eSpark-Backup/alexy-ouden-industrial-iot-board/Design Files/Industrial IOT development board-v2.0/Deliverables/Renderings/3D-ISOMETRIC-view.png

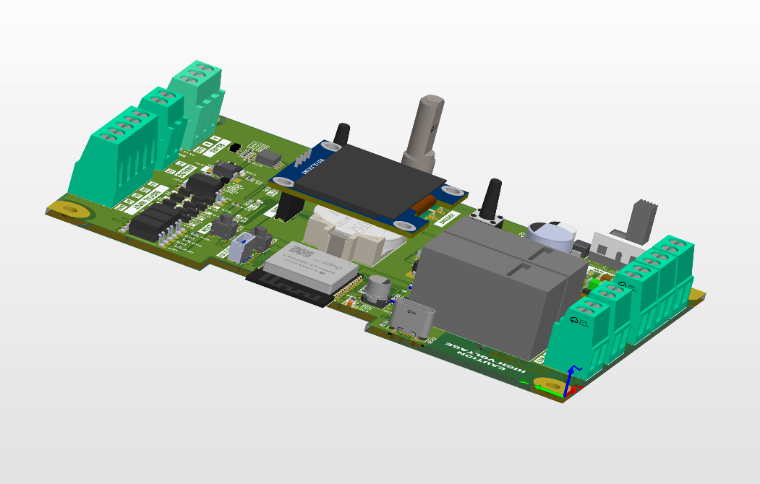
Design Files/Industrial IOT development board-v2.0/Deliverables/Renderings/3D-ISOMETRIC-view.png
