eSpark-Backup/alexy-ouden-industrial-iot-board/Design Files/Industrial IOT development board-v2.0/BOM/Industrial_IOT_Dev_Brd-v2.0.xlsx

# | Item Type | Designator | Description | Footprint | Manufacturer Part Number | Manufacturer | Value | Quantity | Remarks
1 | Capacitor | C1, C7 | CAP CER 0.1UF 50V X7R 0603 | Cap-0603 | CL10B104KB8WPNC | Samsung | 0.1uF | 2
2 | Capacitor | C2 | CAP ALUM 220UF 20% 50V SMD | UCD-220uF-10mmDia | UCD1H221MNL1GS | Nichicon | 220uF | 1
3 | Capacitor | C3 | 47uF 50V 66mA@120Hz ±20% SMD,D6.3xL7.7mm Aluminum Electrolytic Capacitors - SMD ROHS | RVT1H470M0607 | RVT1H470M0607 | ROQANG | 47uF | 1
4 | Capacitor | C4 | CAP CER 0.022UF 100V X7R 0805 | Cap-0805 | CC0805JRX7R0BB223 | Yageo | 22nF | 1
5 | Capacitor | C5, C18, C19 | CAP CER 10UF 50V X7R 1210 | Cap-1210 | GRM32ER71H106KA12L | Murata | 10uF | 3
6 | Capacitor | C6, C17 | CAP CER 1UF 50V X5R 0603 | Cap-0603 | CL10A105KB8NNNC | Samsung | 1uF | 2
7 | Capacitor | C8 | CAP CER 10UF 50V X7R 1210 | Cap-1210 | CC1210KKX7R9BB106 | Yageo | 10uF | 1
8 | Capacitor | C9, C10, C32 | CAP CER 22UF 10V X7R 0805 | Cap-0805 | GRM21BZ71A226ME15L | Murata | 22uF | 3
9 | Capacitor | C22, C30, C33, C34, C35, C37, C38, C39, C45, C78 | CAP CER 0.1UF 16V X7R 0402 | Cap-0402 | CC0402JRX7R7BB104 | Yageo | 0.1uF | 10
10 | Capacitor | C27 | CAP ALUM POLY 120UF 20% 20V SMD | 20SVPF120M | 20SVPF120M | Panasonic | 120uF | 1
11 | Capacitor | C29 | CAP CER 1UF 6.3V X7R 0402 | Cap-0402 | GRM155R70J105KA12J | Murata | 1uF | 1
12 | Capacitor | C31 | 47uF 25V 49mA@120Hz ±20% SMD,D5xL5.4mm Aluminum Electrolytic Capacitors - SMD ROHS | RVT1E470M0505 | RVT1E470M0505 | ROQANG | 47uF | 1
13 | Capacitor | C40 | CAP CER 10PF 50V C0G/NP0 0402 | Cap-0402 | GRM1555C1H100JA01D | Murata | 10pF | 1
14 | Capacitor | ~~C41~~ | ~~CAP CER 10PF 50V C0G/NP0 0402~~ | ~~Cap-0402~~ | ~~GRM1555C1H100JA01D~~ | ~~Murata~~ | ~~DNP~~ | ~~1~~ | ~~DO NOT PLACE~~
15 | Diode | D1 | TVS DIODE 58VWM 93.6VC SMB | SMB_ | SMBJ58A-13-F | Diodes | SMBJ58A-13-F | 1
16 | Diode | D2, D15, D21, D27, D33 | 26.7V 24V SOD-123 ESD and Surge Protection (TVS/ESD) ROHS | SOD-123 | AZ4024-01G | AMAZING | AZ4024-01G | 5
17 | Diode | D3 | 18A 250W 8V 5.5V Bidirectional 5V SOD-323 ESD and Surge Protection (TVS/ESD) ROHS | SOD-323 (Bi-directional) | PESD5V0S1BA,115-ES | ElecSuper | PESD5V0S1BA,115-ES | 1
18 | Diode | D4 | TVS DIODE 26VWM 42.1VC SMB | SMB_ | SMBJ26A-13-F | Diodes | SMBJ26A-13-F | 1
19 | Diode | D5 | 30A 360W 7V 3.5V Bidirectional 3.3V SOD-323 ESD and Surge Protection (TVS/ESD) ROHS | SOD-323 (Bi-directional) | PESD3V3L1BA-N-ES | ElecSuper | PESD3V3L1BA-N-ES | 1
20 | Diode | D8 | 30V Dual Common Cathode 1V@100mA 200mA SOT-23(TO-236) Schottky Barrier Diodes (SBD) ROHS | SOT-23 | BAT54C | Shandong Jingdao Microelectronics | BAT54C | 1
21 | Diode | D9, D10, D13, D19, D25, D31 | DIODE GEN PURP 100V 300MA SOD123 | SOD-123 | 1N4148W-7-F | Diodes | 1N4148W-7-F | 6
22 | Diode | D16, D22, D28, D34 | Independent Type 22.8V~25.6V 500mW 24V SOD-123 Zener Diodes ROHS | SOD-123 | BZT52C24 | BORN | BZT52C24 | 4
23 | Diode | D37, D41 | TVS DIODE 12VWM 19.9VC DO214AA | SMB_ | SMBJ12A | Littelfuse | SMBJ12A | 2
24 | Diode | D39, D43 | DIODE ZENER 3.3V 200MW SOD323F | SOD323F | MM3Z3V3B | ON Semiconductor / Fairchild | MM3Z3V3B | 2
25 | Diode | D50 | SOT-23 TVS ROHS | SOT-23 | SM712 | TECH PUBLIC | SM712 | 1
26 | Fuse | F1 | 24V 750mA 100A 1.5A 1210 Resettable Fuses ROHS | FUSE-1210 | 1210L075/24PR | Littlefuse | 1210L075/24PR | 1
27 | Fuse | F2 | 6V 1.5A 50A 3A 0805 Resettable Fuses ROHS | Fuse-0805 | 0805L150SLYR | Littelfuse | 0805L150SLYR | 1
28 | Fuse | F3 | PTC Resettable Fuse 6V 100A 2-Pin 0805 T/R | Fuse-0805 | SMD0805B110TF | Yageo | SMD0805B110TF | 1
29 | Ferrite Bead | FB1 | Ferrite Beads Multi-Layer 120Ohm 25% 100MHz 2A 50mOhm DCR 0603 Paper T/R | IND-0603 (1608 Metric) | BLM18PG121SN1D | Murata Electronics | 120R | 1
30 | Terminal Block | J1, J9, J10, J13, J14, J20 | 1x2P 18A -40℃~+105℃ 250V Green 12~30 Straight 5.08mm 2.5 1 2 Plugin,P=5.08mm Screw terminal ROHS | DB128L-5.08-2P-GN-S | DB128L-5.08-2P-GN-S | DORABO | DB128L-5.08-2P-GN-S | 6
31 | USB Connector | J2 | 5A 1 16P Mother -25℃~+85℃ Type-C SMD USB Connectors ROHS | U263-163N-4BQC65 | U263-163N-4BQC65 | XKB Connection | U263-163N-4BQC65 | 1
32 | Header | J3 | 1x6P SH 1 1mm 6 SMD,P=1mm Wire To Board / Wire To Wire Connector ROHS | Voltlink Target | C145963 | BOOMELE | Voltlink Target | 1
33 | Header | J4 | 2mm 2.54mm Plugin 2.5A -40℃~+105℃ Straight 1x4P Top 8.5mm 4 Square Hole Plugin,P=2.54mm Female Headers ROHS | HDR1X4 Female | PM2.54-1*4 | ZHOURI | PM2.54-1*4 | 1
34 | Battery Connector | J5 | Battery base CR2032 SMD Battery Connectors ROHS | CR2032-BS-6-1 | CR2032-BS-6-1 | Q&J | CR2032-BS-6-1 | 1
35 | Terminal Block | J19 | 1x5P 20A -40℃~+105℃ 300V Green 12~30 Direct Insert 5.08mm 2.5 1 5 Plugin,P=5.08mm Screw Terminal Blocks ROHS | DB128V-5.08-5P-GN-S | DB128V-5.08-5P-GN-S | DORABO | DB128V-5.08-5P-GN-S | 1
36 | Terminal Block | J22 | 1x3P 18A -40℃~+105℃ 250V Green 12~30 Direct Insert 5.08mm 2.5 1 3 Plugin,P=5.08mm Screw Terminal Blocks ROHS | DB128L-5.08-3P-GN-S | DB128L-5.08-3P-GN-S | DORABO | DB128L-5.08-3P-GN-S | 1
37 | Header | J23 | Gold 250V 3A Straight Square Pins 2.5mm 2P 260℃ 6mm -40℃~+105℃ 3mm 2.54mm Plugin Black Brass 1x2P Plugin,P=2.54mm Pin Headers ROHS | HDR1X2_ | X6511WV-02H-C60D30 | XKB | X6511WV-02H-C60D30 | 1
38 | Power Relays | K1, K2 | RELAY GEN PURPOSE SPST 16A 5V | G5RL-1A-E-HR-DC5 | G5RL-1A-E-HR-DC5 | Omron | G5RL-1A-E-HR-DC5 | 2
39 | Inductor | L1 | 4.5A 4.7uH ±20% SMD,10.1x10.1mm Power Inductors ROHS | YSLF1045-4R7M | YSLF1045-4R7M | YJYCOIN | 4.7uH | 1
40 | LED | LED1, LED2, LED3 | RED LED 0603 Light Emitting Diodes | LED-0603 | NCD0603R3 | Foshan NationStar Optoelectronics | RED | 3
41 | LED | LED5 | SMD5050 Light Emitting Diodes (LED) ROHS | WS2812B-XF02/W | WS2812B-XF02/W | Worldsemi | WS2812B-XF02/W | 1
42 | LED | LED8, LED9 | Emerald 0603 Light Emitting Diodes (LED) ROHS | LED-0603 | NCD0603G2 | Foshan NationStar Optoelectronics | Emerald | 2
43 | MOSFET | Q1 | MOSFET N-CH 60V 15A PWRDI3333 | PowerDI-3333-8 | DMT6007LFG-7 | Diodes | DMT6007LFG-7 | 1
44 | MOSFET | Q4 | N-CHANNEL 20-V (D-S) MOSFET | Sot-23 | SI2302CDS | TECH PUBLIC | Si2302CDS | 1
45 | MOSFET | Q5, Q6 | 40V 100mW 100@10mA,1V 200mA 300MHz 300mV@50mA,5mA NPN -55℃~+150℃@(Tj) SOT-723 Bipolar Transistors - BJT ROHS | SOT-723 | MMBT3904M | TECH PUBLIC | MMBT3904M | 2
46 | Resistor | R1, R2, R36, R37, R123 | RES 10K OHM 1% 1/16W 0402 | Res-0402 | RC0402FR-0710KL | Yageo | 10K | 5
47 | Resistor | R6 | RES 100K OHM 5% 1/10W 0603 | Res-0603 | RC0603JR-07100KL | Yageo | 100K | 1
48 | Resistor | R7 | RES 3.9K OHM 1% 1/16W 0402 | Res-0402 | RC0402FR-073K9L | Yageo | 3.9K | 1
49 | Resistor | R8 | RES 499 OHM 1% 1/16W 0402 | Res-0402 | RC0402FR-07499RL | Yageo | 499R | 1
50 | Resistor | R12 | RES 240 OHM 1% 1/16W 0402 | Res-0402 | RC0402FR-07240RL | Yageo | 240R | 1
51 | Resistor | R13, R14 | RES 5.1K OHM 1% 1/16W 0402 | Res-0402 | RC0402FR-075K1L | Yageo | 5.1K | 2
52 | Resistor | R17 | RES 3.3K OHM 1% 1/16W 0402 | Res-0402 | RC0402FR-073K3L | Yageo | 3.3K | 1
53 | Resistor | R21 | RES 1K OHM 1% 1/16W 0402 | Res-0402 | RC0402FR-071KL | Yageo | 1K | 1
54 | Resistor | ~~R24~~ | ~~RES SMD 100K OHM 0.1% 1/16W 0402~~ | ~~Res-0402~~ | ~~RT0402BRD07100KL~~ | ~~Yageo~~ | ~~DNP~~ | ~~1~~ | ~~DO NOT PLACE~~
55 | Resistor | R28, R35, R40 | RES SMD 10K Ohm 1% 1/10W 0603 | Res-0603 | RC0603FR-0710KL | Yageo | 10K | 3
56 | Resistor | R33, R34, R41, R42, R43, R46, R52, R53, R64, R68, R72, R76, R117, R120 | RES 4.7K OHM 1% 1/16W 0402 | Res-0402 | RC0402FR-074K7L | Yageo | 4.7K | 14
57 | Resistor | R38 | RES 75 OHM 5% 1/16W 0402 | Res-0402 | RC0402JR-0775RL | Yageo | 75R | 1
58 | Resistor | R44, R45, R115, R116, R118, R119, R121 | RES 0 OHM JUMPER 1/16W 0402 | Res-0402 | RC0402FR-070RL | Yageo | 0R | 7
59 | Resistor | R56, R57 | RES 47K OHM 1% 1/16W 0402 | Res-0402 | RC0402FR-0747KL | Yageo | 47K | 2
60 | Resistor | R60, R61 | RES 680 OHM 1% 1/16W 0402 | Res-0402 | RC0402FR-07680RL | Yageo | 680R | 2
61 | Resistor | R66, R70, R74, R78 | RES 1.5K OHM 1% 1/10W 0603 | Res-0603 | RC0603FR-071K5L | Yageo | 1.5K | 4
62 | Resistor | R80, R84 | RES SMD 3.74KOHM 0.1% 1/10W 0603 | Res-0603 | RT0603BRD073K74L | Yageo | 3.74K | 2
63 | Resistor | R82, R86 | RES SMD 1.8K OHM 0.1% 1/10W 0603 | Res-0603 | RT0603BRD071K8L | Yageo | 1.8k | 2
64 | Resistor | R122 | RES 120 OHM 1% 1/10W 0603 | Res-0603 | RC0603FR-07120RL | Yageo | 120R | 1
65 | Switch | SW1 | 3A Direct Insert Single Pole Double Throw (SPDT) 125V Black 10,000 times Plugin Slide Switches ROHS | SS-12D10L9 | SS-12D10L9 | XKB Connectivity | SS-12D10L9 | 1
66 | Switch | SW2, SW3 | No NO 50mA 4.5mm 100000 260gf 12V -30℃~+85℃ 4.5mm 4.3mm Black Round Button Brick nogging SPST SMD Tactile Switches ROHS | TS-1109S-C-B | TS-1109S-C-B | XKB Connectivity | TS-1109S-C-B | 2
67 | Switch | SW4, SW5 | 6mm 12mm Round Button 50mA Standing paste 6mm SPST 12V SMD,6x6mm Tactile Switches ROHS | TS-1002S-12026C | TS-1002S-12026C | XUNPU | TS-1002S-12026C | 2
68 | Switch | SW7 | METAL SHAFT ENCODERS | EC11E1820402 | EC11E1820402 | Alps Electric | EC11E1820402 | 1
69 | IC | U1 | IC REG BUCK 5V 2A TSOT26 | TSOT-23-6 | AP63205WU-7 | Diodes | AP63205WU-7 | 1
70 | IC | U2 | OR Controller N+1 ORing Controller N-Channel 1:1 SOT-23-6 | SOT-23-6 | LM74700QDBVRQ1 | Texas Instruments | LM74700QDBVRQ1 | 1
71 | IC | U3 | IC REG LINEAR 3.3V 1.5A TO252-3 | TO-252-2L | AP7363-33D-13 | Diodes | AP7363-33D-13 | 1
72 | IC | U4 | 6A 12V 150W 6V Unidirectional 5V SOT-23-6 ESD and Surge Protection (TVS/ESD) ROHS | SOT-23-6 | USBLC6-2SC6 | TECH PUBLIC | USBLC6-2SC6 | 1
73 | IC | U6 | 1.6-V TO 5.5-V, 40-M, 2.5-A, LOW | SOT-583 | TPS2116DRLR | Texas Instruments | TPS2116DRLR | 1
74 | IC | U8 | SMD MODULE, ESP32-S3R8 WITH 3.3V | 41-SMD Module | ESP32-S3-WROOM-1-N16R8 | Espressif Systems | ESP32-S3-WROOM-1-N16R8 | 1
75 | IC | U10 | IC RTC CLOCK/CALENDAR I2C 8SO | SOIC-8(0.154", 3.90mm Width) | PCF8563T/F4,118 | NXP Semiconductors | PCF8563T/F4,118 | 1
76 | IC | U13, U15, U17, U19 | OPTOISOLATOR 5.3KV TRANS 4SMD | SFH617A-2X009T | SFH617A-2X009T | Vishay | SFH617A-2X009T | 4
77 | IC | U21 | IC ADC 16BIT SIGMA-DELTA 10VSSOP | VSSOP-10 | ADS1115IDGSR | Texas Instruments | ADS1115IDGSR | 1
78 | IC | U26 | SOP-8 RS-485/RS-422 ICs ROHS | SOP-8 | SP3485EIM/TR | HGSEMI | SP3485EIM/TR | 1
79 | Crystal | X1 | 32.768kHz 7pF ±20ppm MC-146 Crystals ROHS | MC-146_ | Q13MC14620001 | Seiko Epson | 32.768kHz | 1
80 | Peripheral | - | 2.54mm Pitch FC-6 JTAG ISP AVR Download Cable Wire Line 6P 6pin 30CM 300mm Connector Gray Flat Ribbon Data Cable 28AWG | - | - | - | - | Cable (x1) | Aliexpress (https://vi.aliexpress.com/item/4001292996821.html?gatewayAdapt=glo2vnm4itemAdapt)
81 | Peripheral | - | CR2032 3V Lithium Battery DL2032 BR2032 5004LC 2032 for watch, toys, car key, Calculator +screwdrive | - | - | - | - | Coin Cell (x1) | Aliexpress (https://vi.aliexpress.com/item/1005006435802328.html?gatewayAdapt=glo2vnm4itemAdapt)
82 | Peripheral | - | 1.3 Inch OLED Display Module 128X64 LCD Display 4PIN I2C IIC Communicate For Arduino | - | - | - | - | 1 | Aliexpress (https://vi.aliexpress.com/item/1005008113687250.html?gatewayAdapt=glo2vnm4itemAdapt)
83 | Peripheral | - | 3.7V 3500mah 18650 Battery For Samsung 35E INR 18650 20A Lithium Lon Battery Replacement External Battery+Charger | - | - | - | - | 1 | Aliexpress (https://vi.aliexpress.com/item/1005005911961694.html?gatewayAdapt=glo2vnm4itemAdapt) | 18650 battery (x1) - This one is used cell category... New and original not available
84 | Peripheral | - | - | - | POE160S | - | - | 1 | Omada (https://www.omadanetworks.com/us/business-networking/omada-accessory-poe-adapter/poe160s/)
85 | Peripheral | - | Open top 3A 2.54mm P=2.54mm Shunts, Jumpers ROHS | Custom | X2541-A1NIB | XKB Connection | - | 5
