eSpark-Backup/alexy-ouden-industrial-iot-board/(list of files, cad)

Other CAD files:
Design Files/Industrial IOT development board-v2.0/Deliverables/Supporting Files/Industrial_IOT_Dev_Brd-v2.0.DXF
Design Files/Industrial IOT development board-v2.0/Deliverables/Supporting Files/Industrial_IOT_Dev_Brd-v2.0..DWG
