eSpark-Backup/alexy-ouden-industrial-iot-board/Design Files/Industrial IOT development board-v2.0/Schematic/Industrial_IOT_Dev_Brd-v2.0.pdf

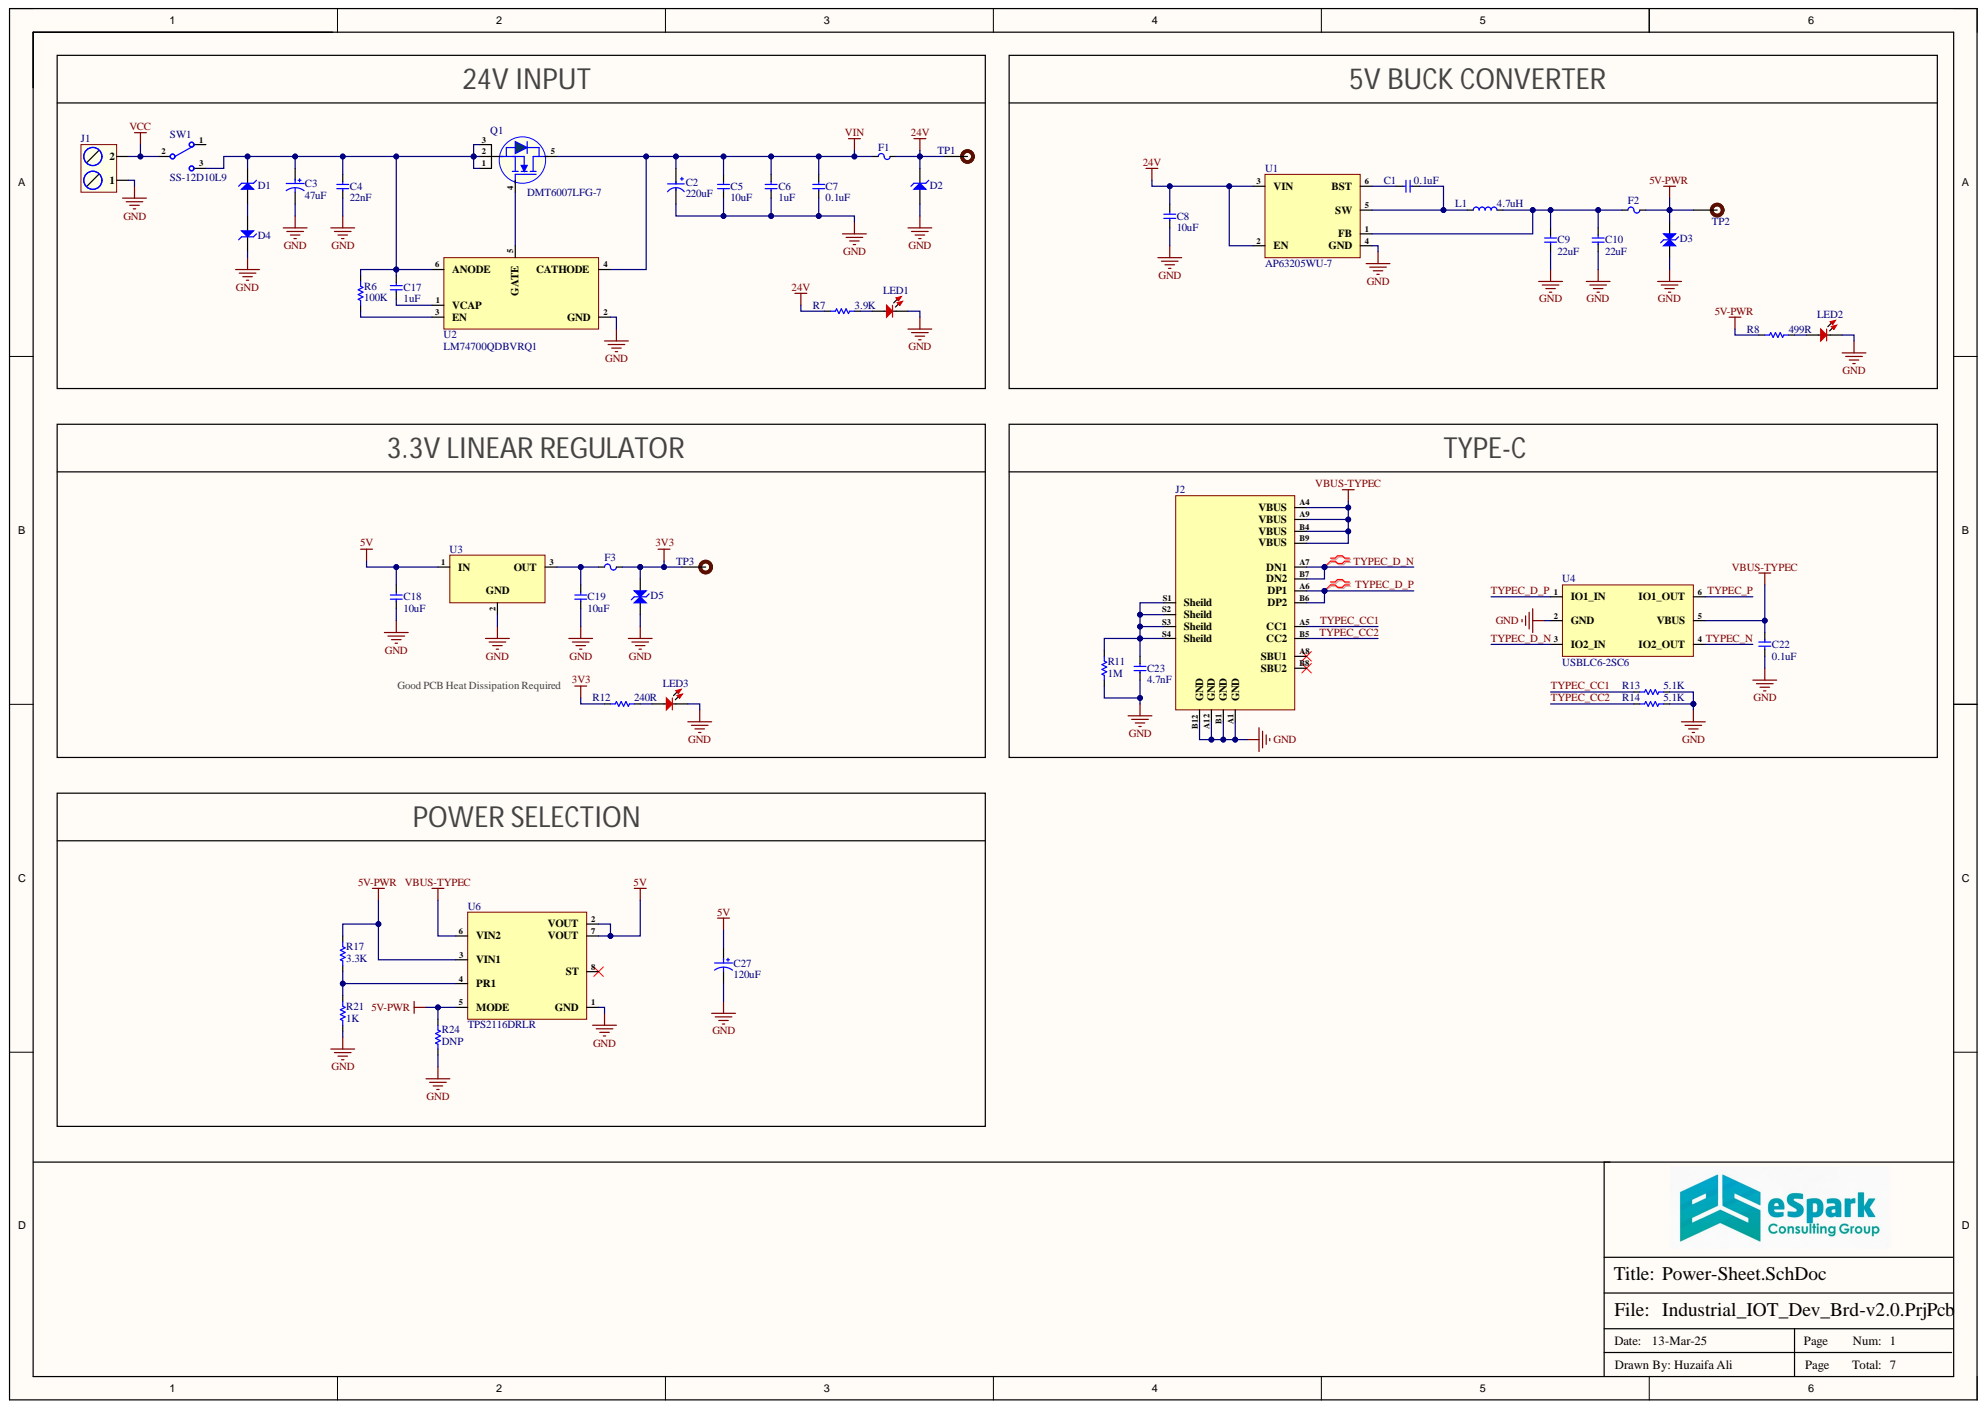
[picture p7: page 1]

Good PCB Heat Dissipation Required

Date: 13-Mar-25 | Page Num: 1

Drawn By: Huzaifa Ali | Page Total:

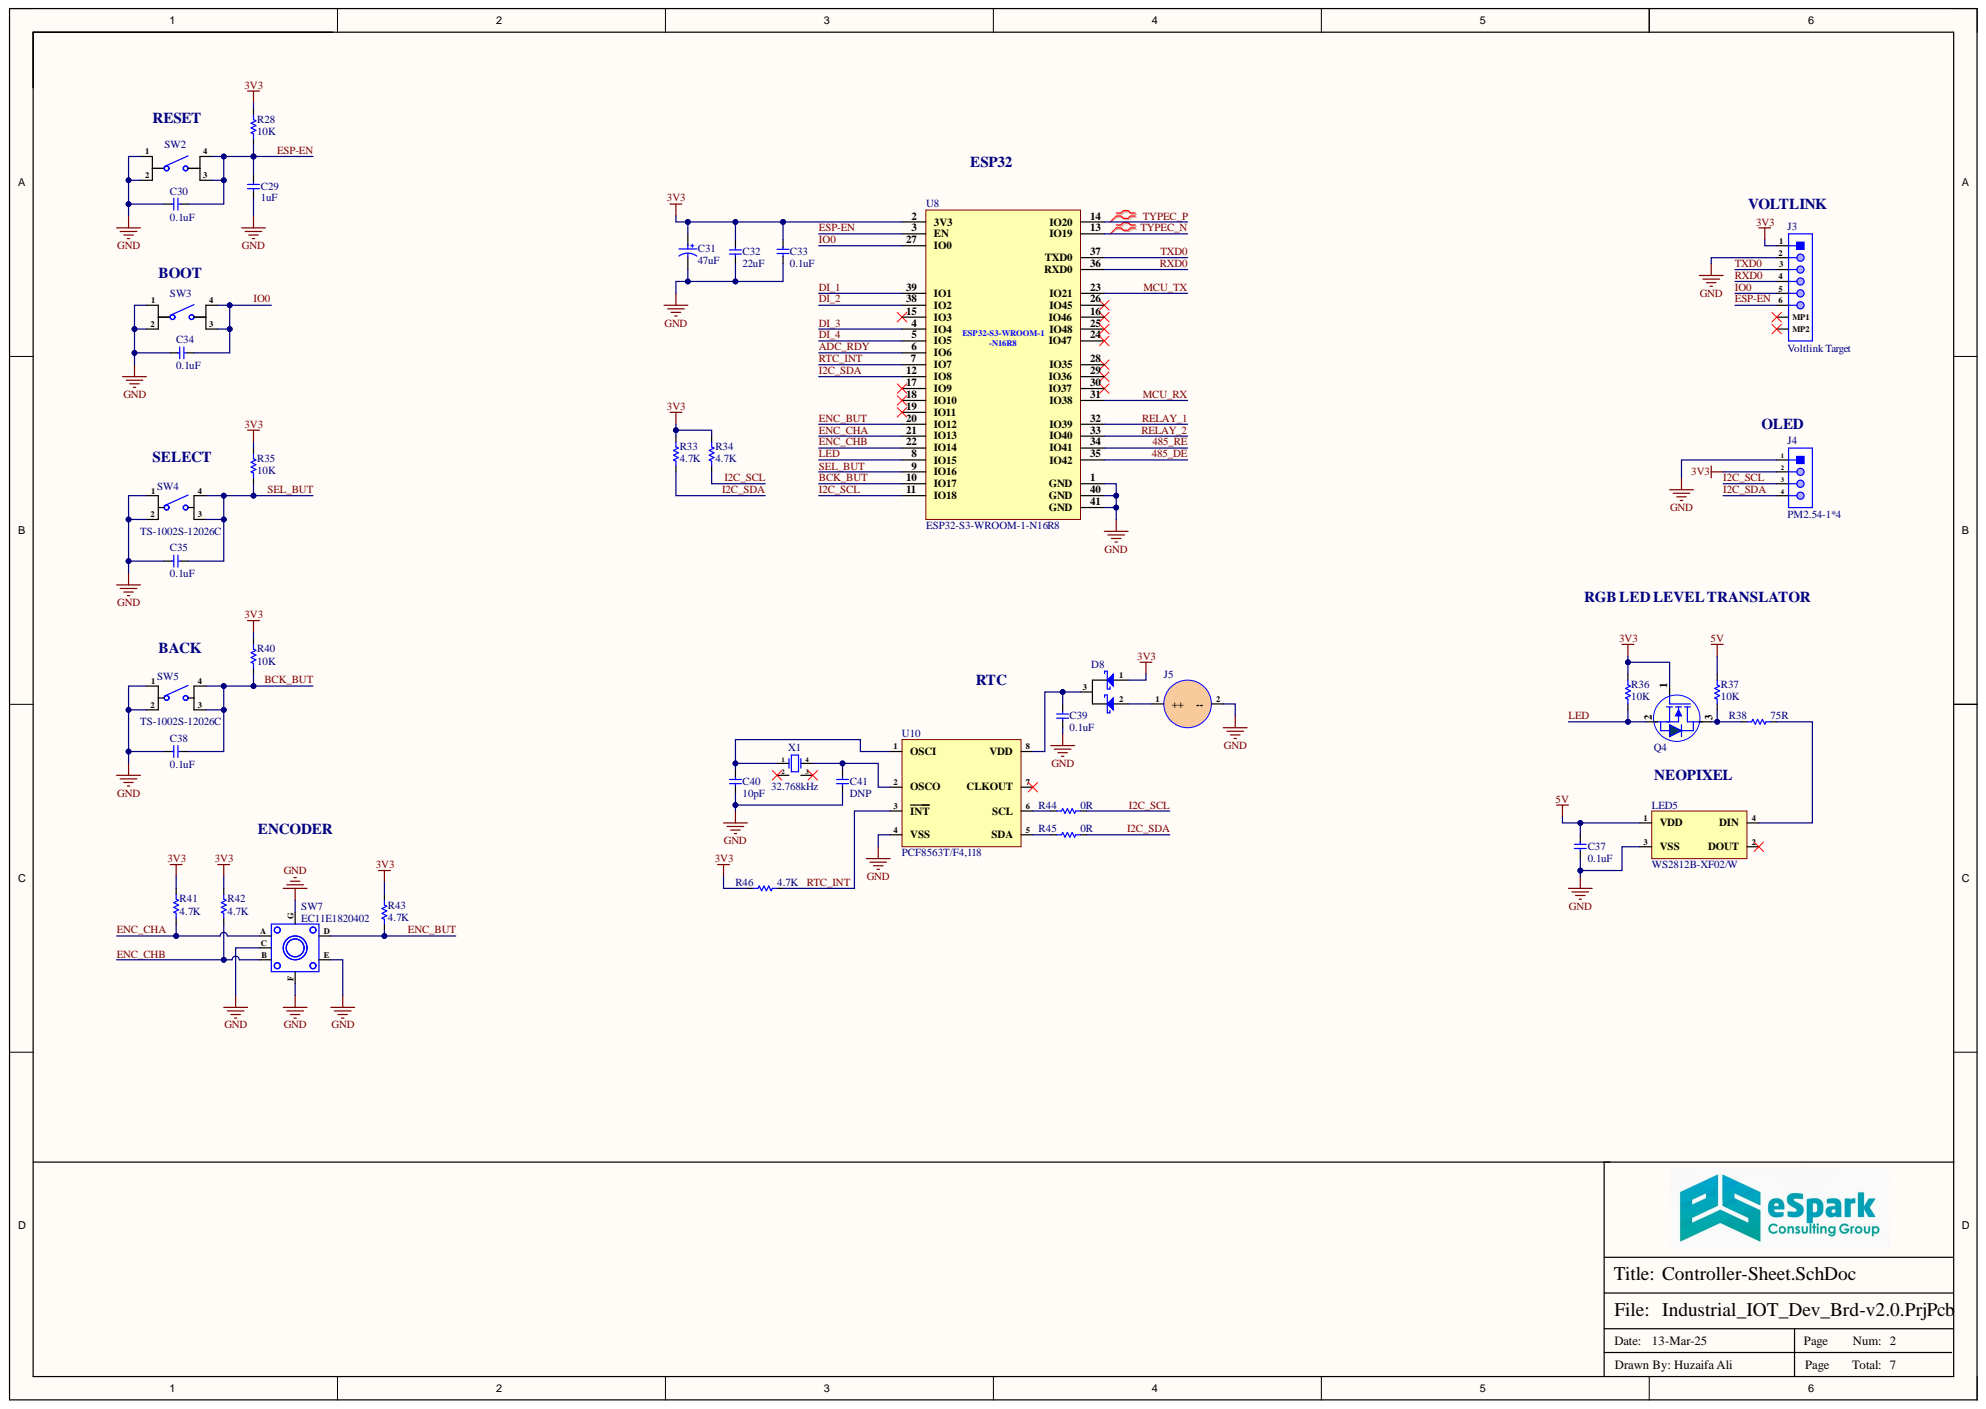
[picture p8: page 2]

Date : 1 3-M ar-2 5 | P a g e Nu m : 27

Drawn By: Hu z aifa Ali | P a g e T ota l :

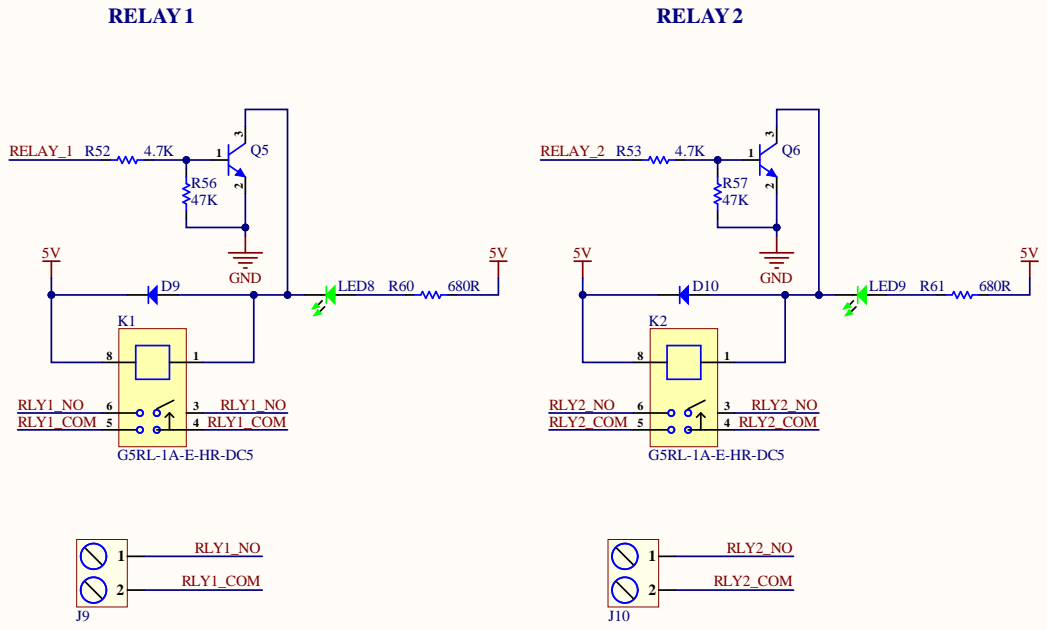
[picture p9: page 3]

Power-Relay-Sheet.SchDoc

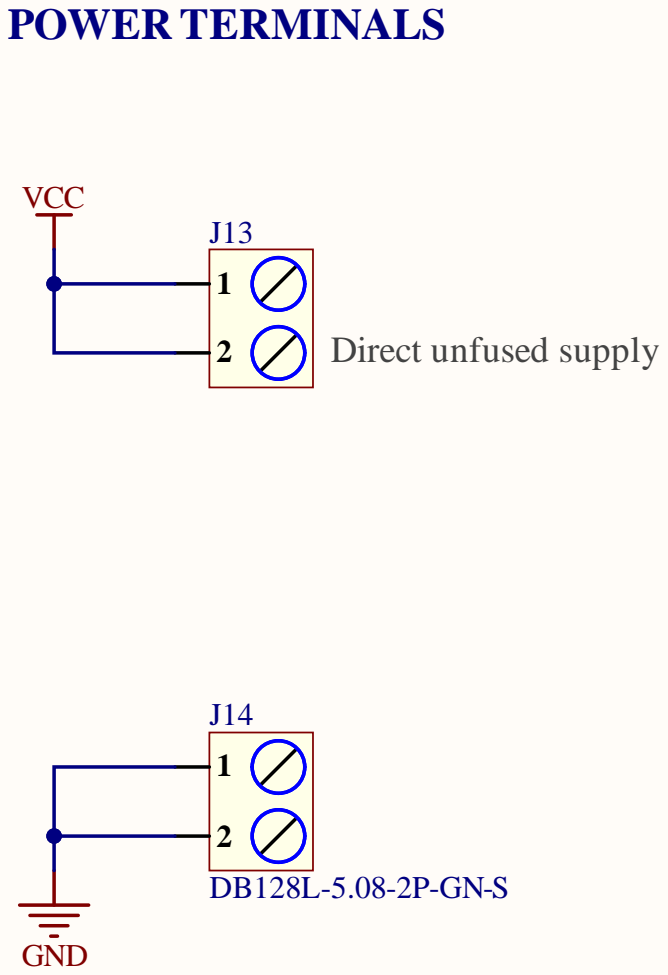
[picture p10: page 4]

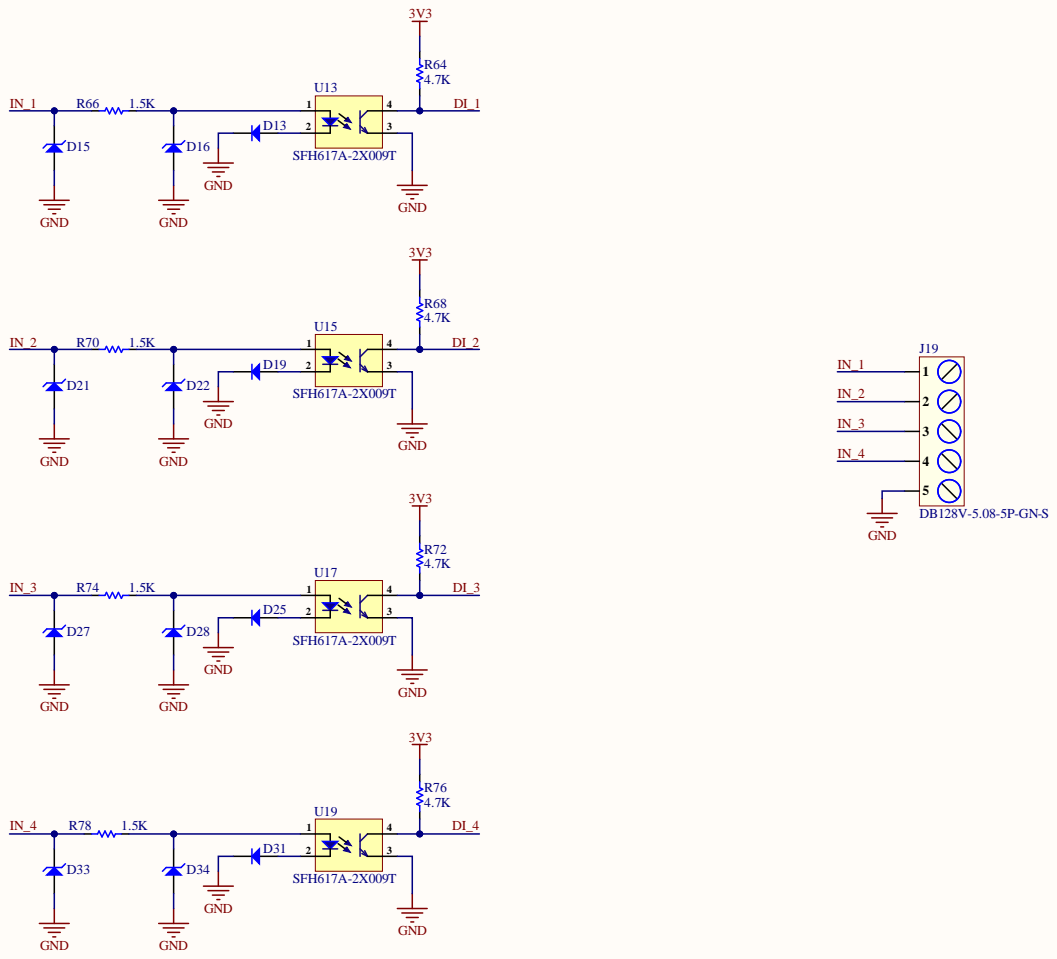
[picture p11: page 5]

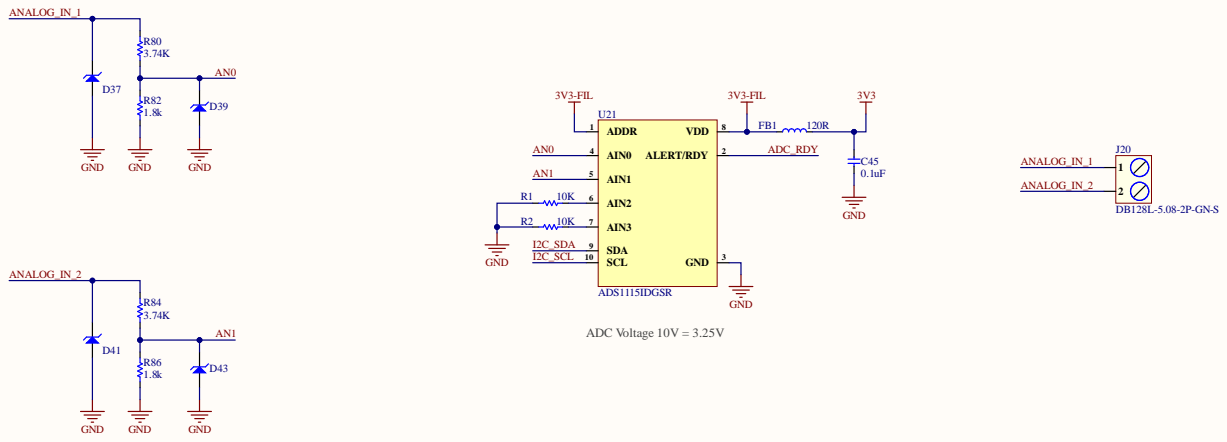
[picture p12: page 6]

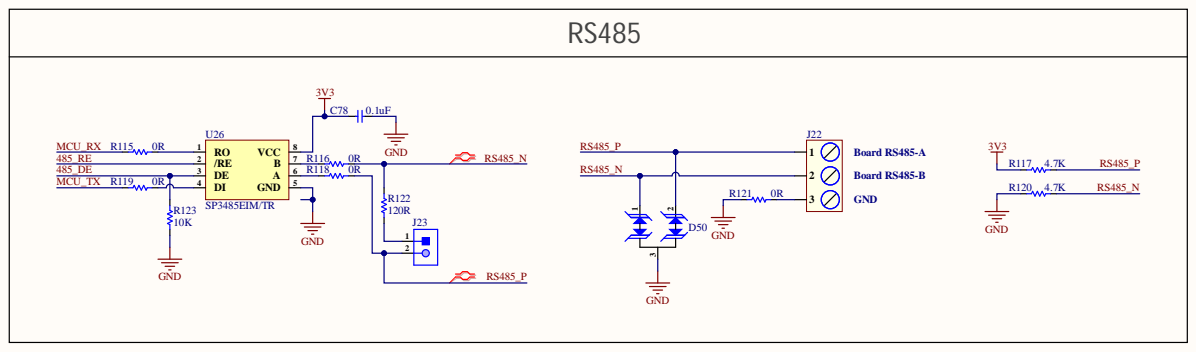
[picture p13: page 7]
