eSpark-Backup/alexy-ouden-industrial-iot-board/Design Files/Industrial IOT development board-v2.0/Deliverables/Assembly Drawings/Industrial_IOT_Dev_Brd-v2.0.pdf

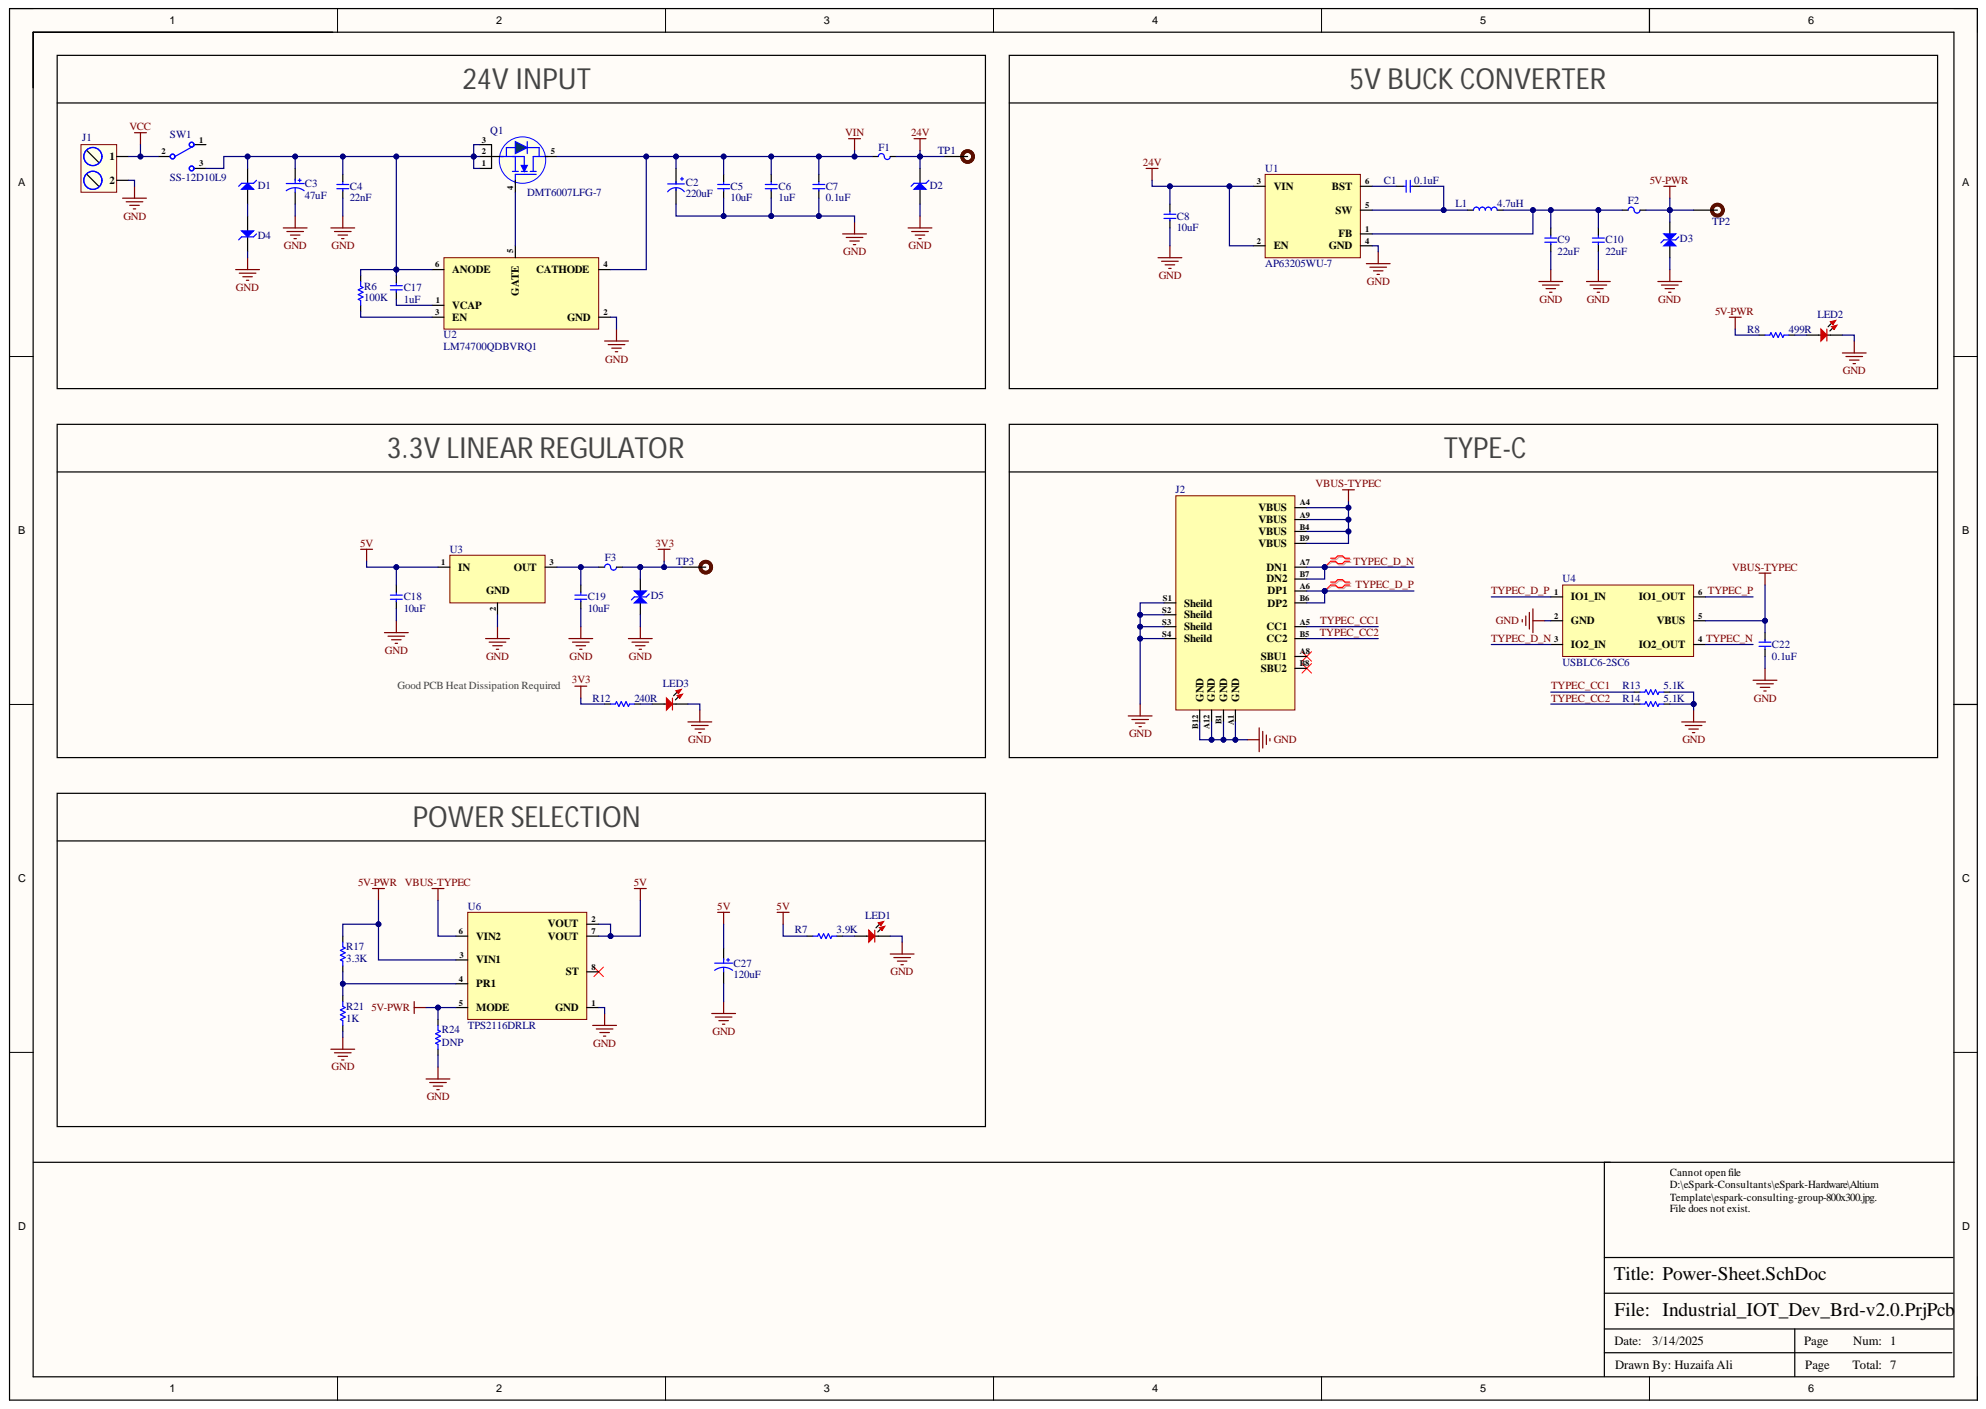
[picture p14: page 1]

Good PCB Heat Dissipation Required

Cannot open file
D:\eSpark-Consultants\eSpark-Hardware\Altium
Template\espark-consulting-group-800x300.jpg.
File does not exist.

Date: 3/14/2025 | Page Num: 1

Drawn By: Huzaifa Ali | Page Total: 7

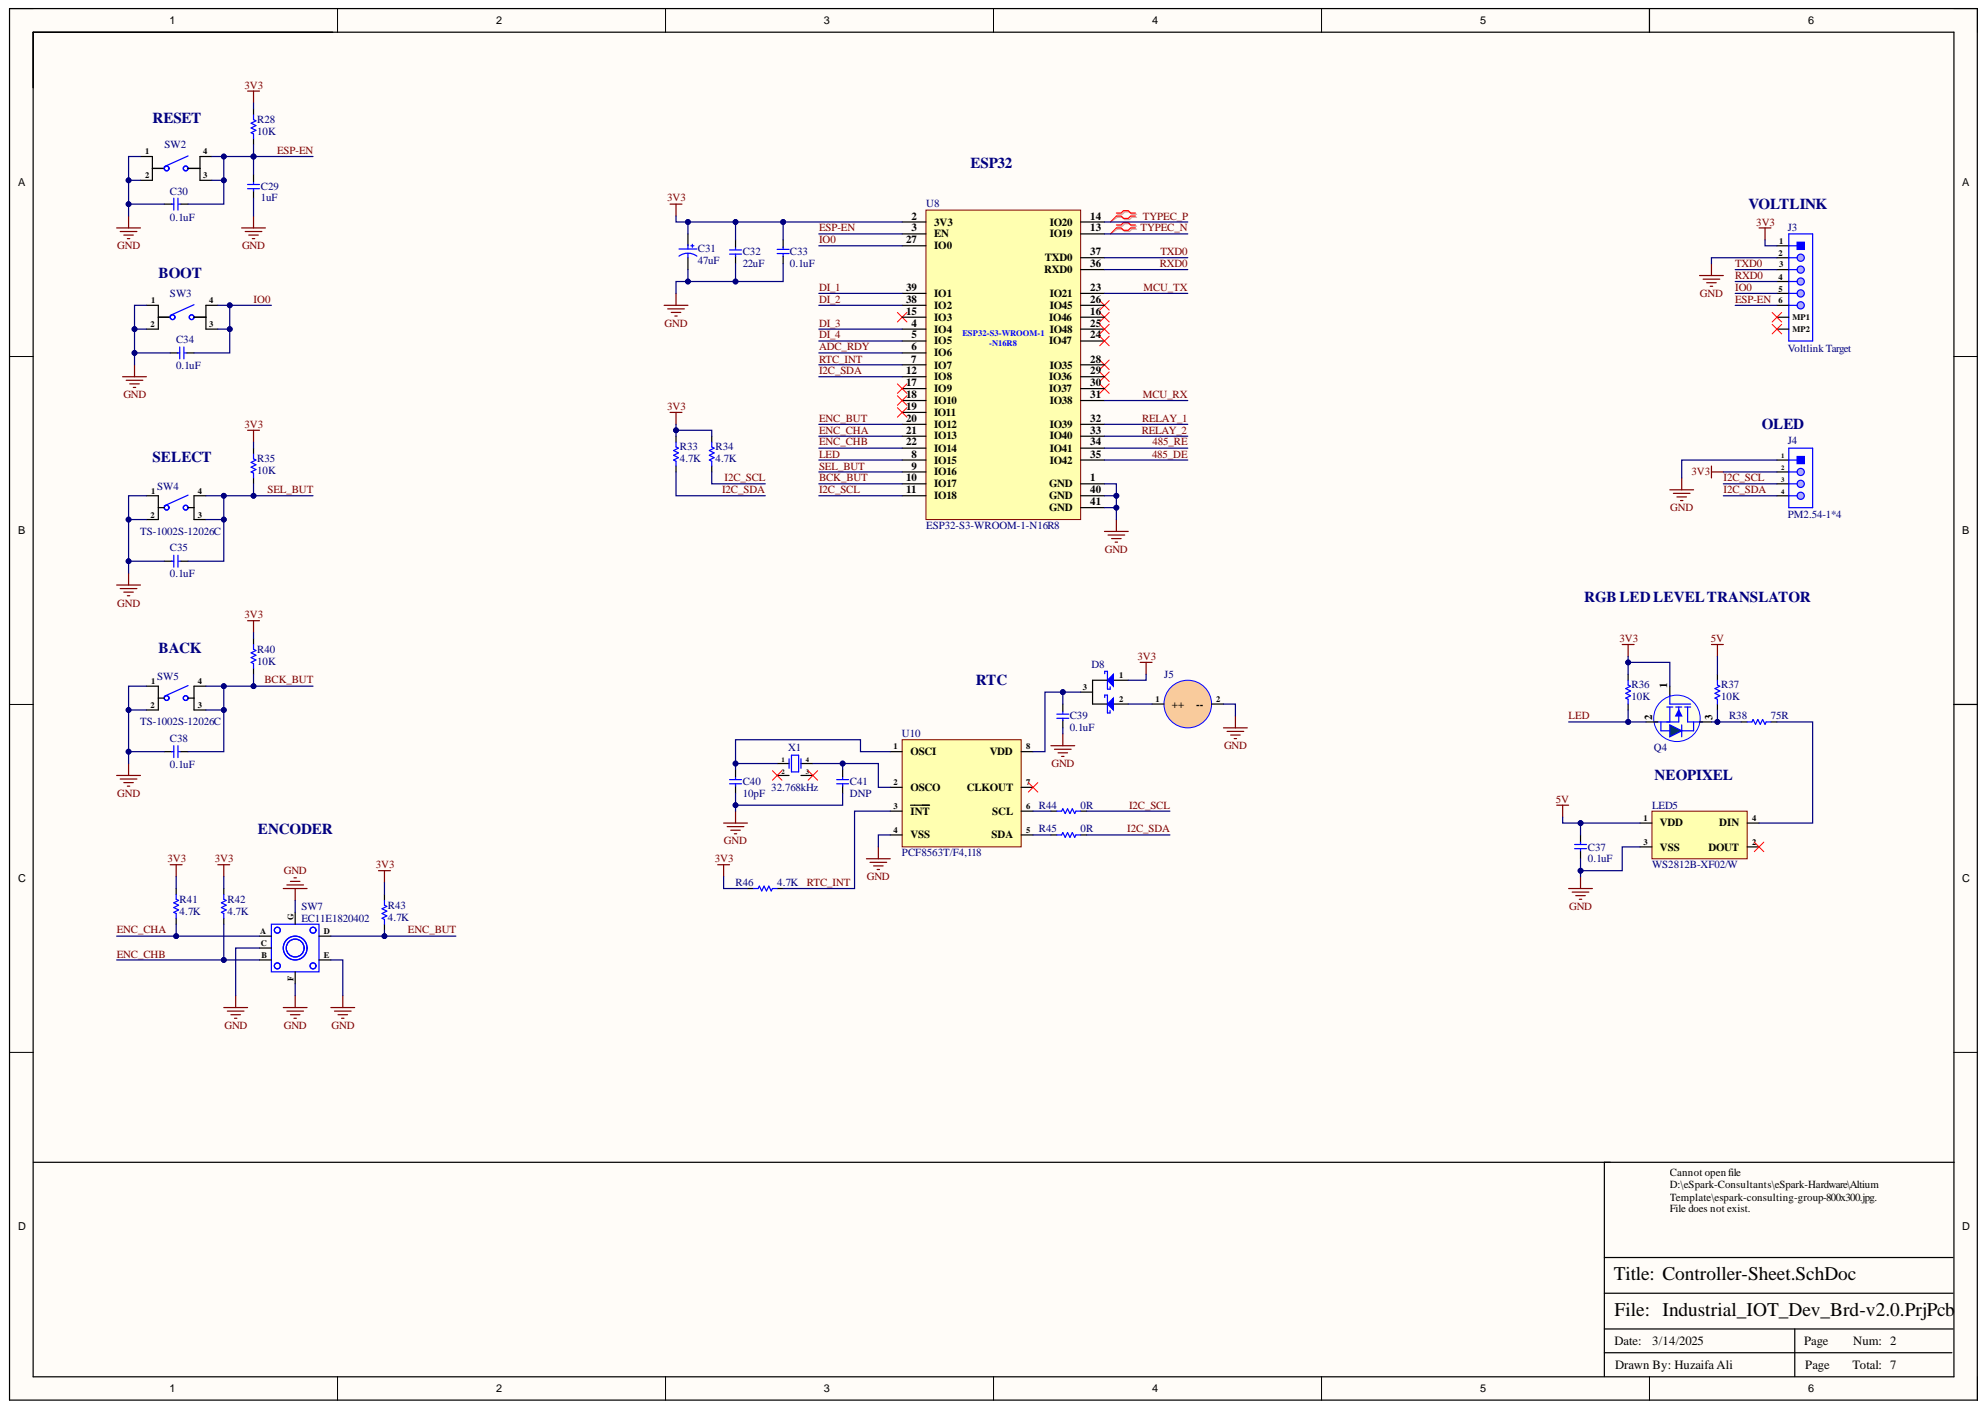
[picture p15: page 2]

Can
D:\eSpark-Consultan
Template\espark-consulting-grou
File does

Date : 3/1 4/2 0 2 5 | P a g e Nu m : 27

Drawn By: Hu z aifa Ali | P a g e T ota l :

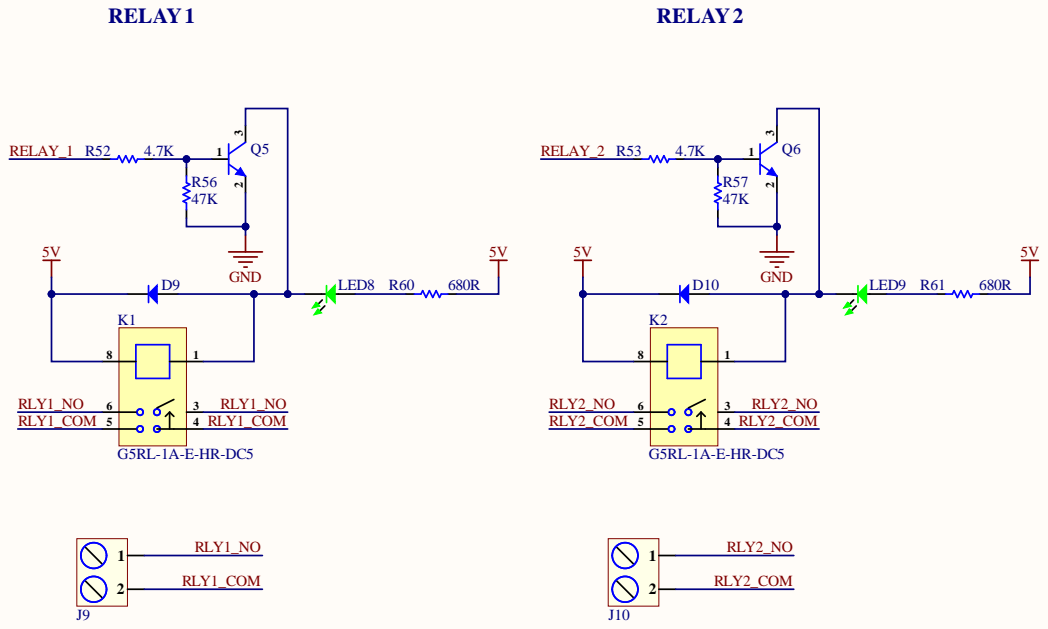
[picture p16: page 3]
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

Power-Relay-Sheet.SchDoc

Date: 3/14/2025 | Page Num: 3

Drawn By: Huzaifa Ali | Page Total: 7

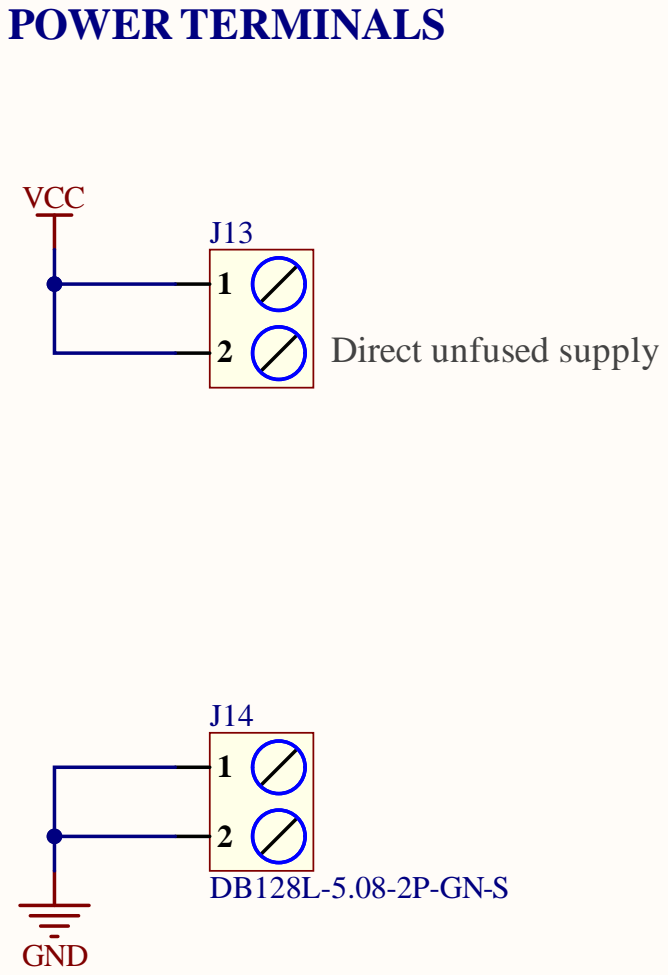
[picture p17: page 4]
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

Date: 3/14/2025 | Page Num: 4

Drawn By: Huzaifa Ali | Page Total: 7

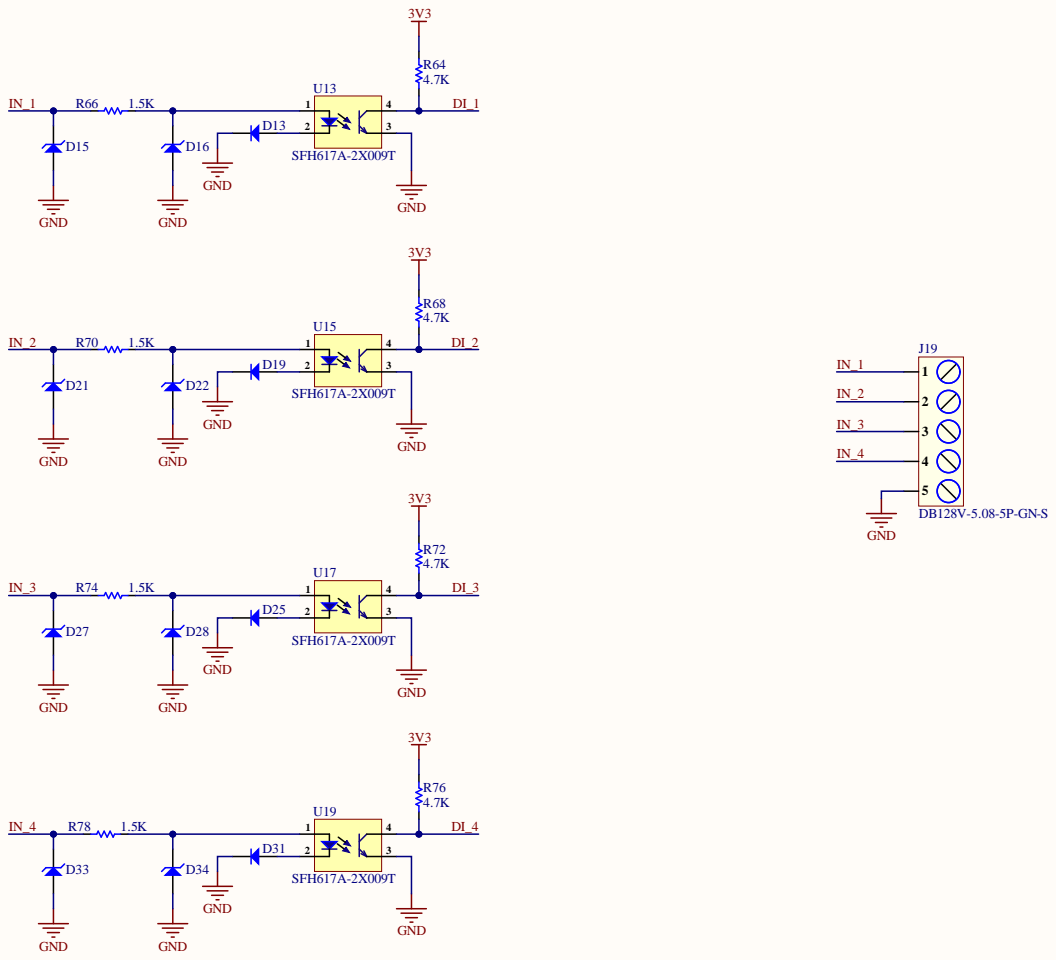
[picture p18: page 5]

Can
D:\eSpark-Consultan
Template\espark-consulting-grou
File does

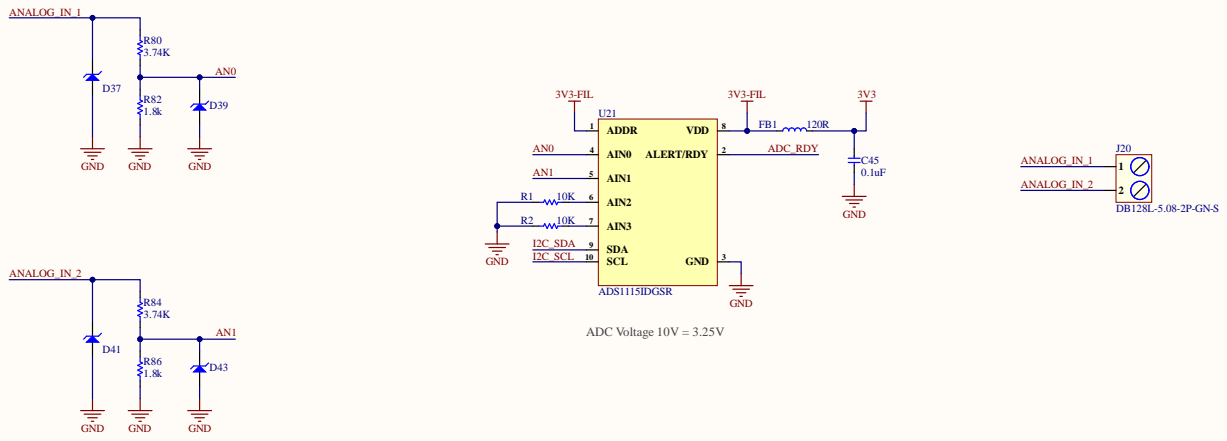
[picture p19: page 6]

Can
D:\eSpark-Consultan
Template\espark-consulting-grou
File does

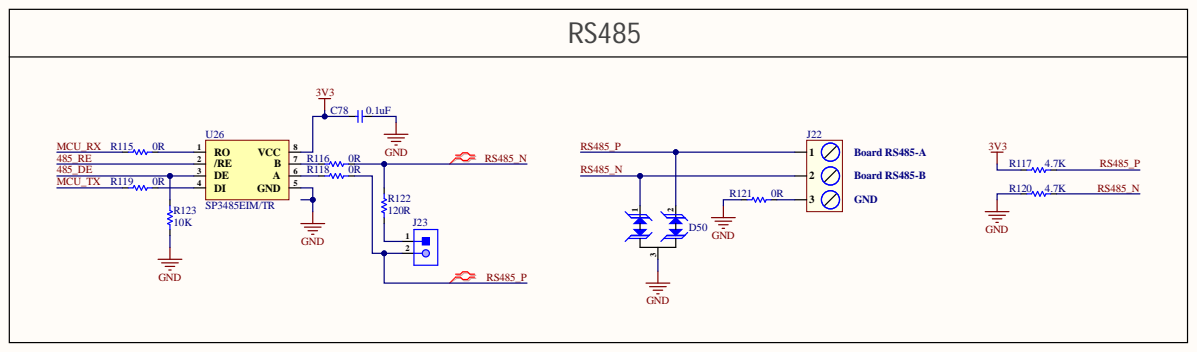
[picture p20: page 7]

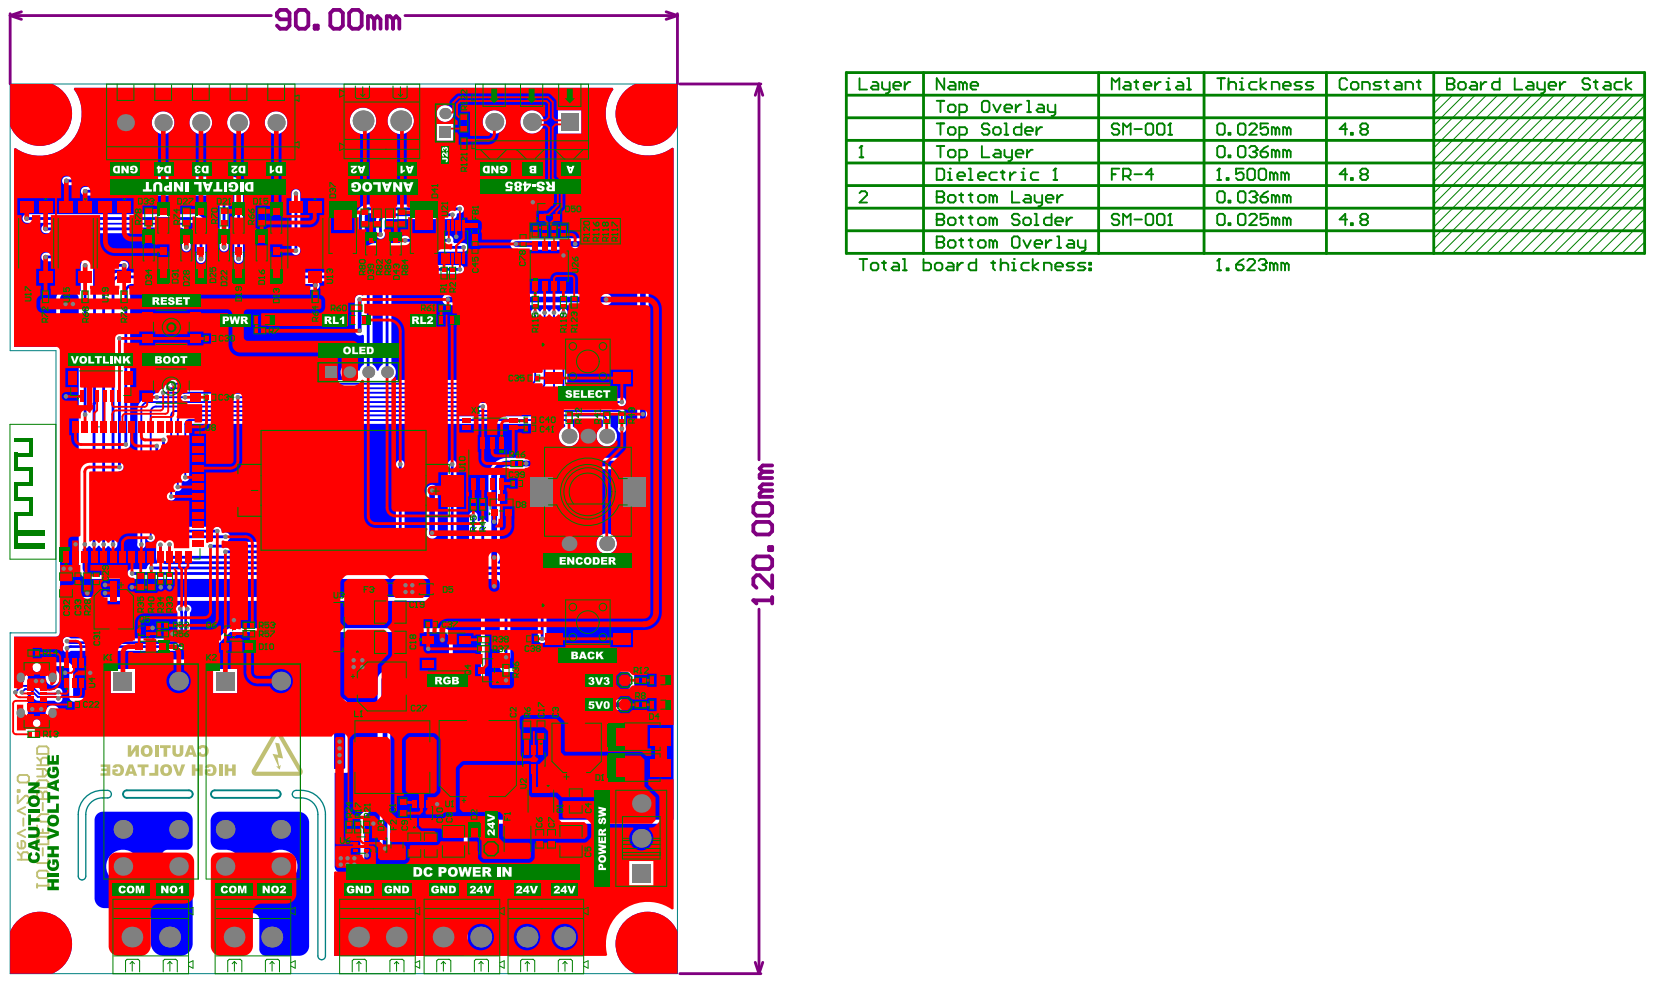
[picture p21: page 8]
