eSpark-Backup/alexy-ouden-industrial-iot-board/Design Files/Industrial IOT development board-v2.0/Deliverables/Assembly Drawings/Assembly Drawing.pdf

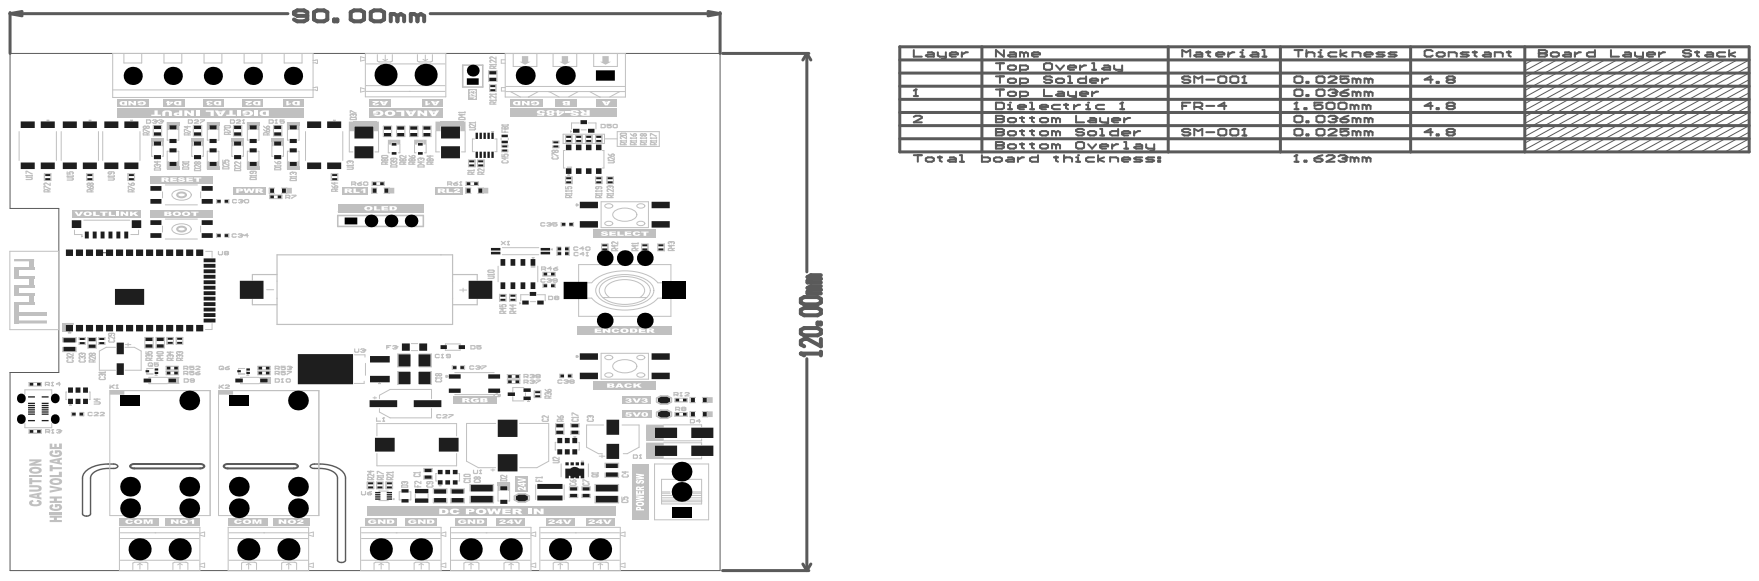
[picture p22: page 1]

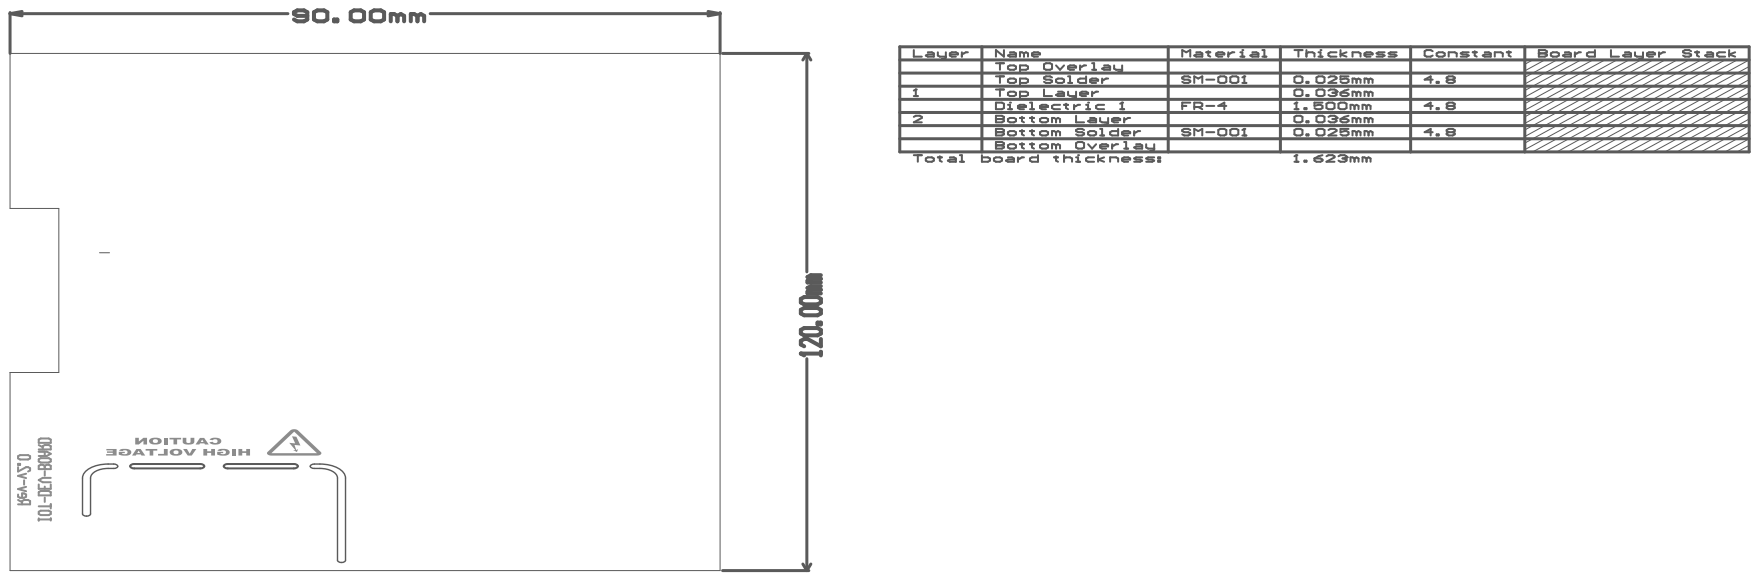
[picture p23: page 2]

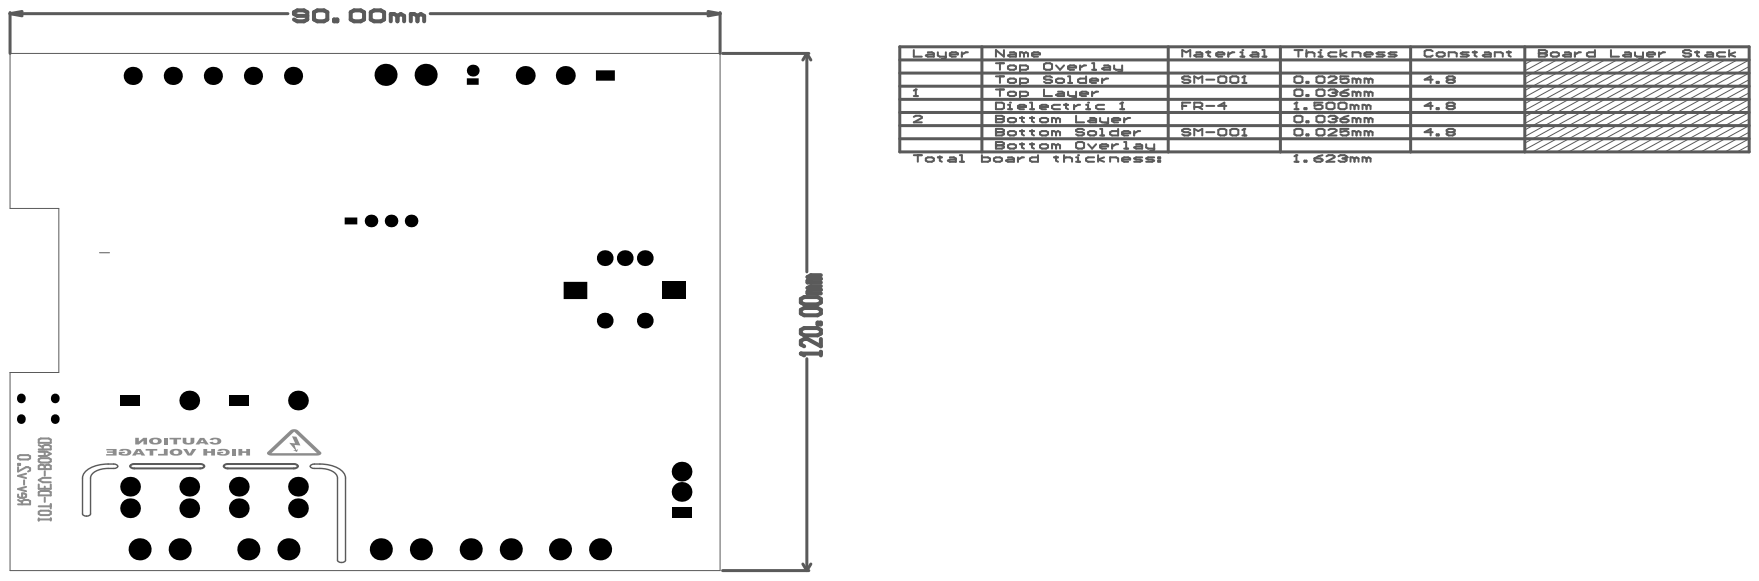
[picture p24: page 4]
