eSpark-Backup/alexy-ouden-industrial-iot-board/(list of files, drawings)

Other design files:
Design Files/Industrial IOT development board-v1.0/Industrial_IOT_Dev_Brd-v1.0.PrjPcb
Design Files/Industrial IOT development board-v2.0/Analog-Input-Sheet.SchDoc
Design Files/Industrial IOT development board-v2.0/Controller-Sheet.SchDoc
Design Files/Industrial IOT development board-v2.0/Digital-Input-Sheet.SchDoc
Design Files/Industrial IOT development board-v2.0/Industrial_IOT_Dev_Brd-v2.0.PcbDoc
Design Files/Industrial IOT development board-v2.0/Industrial_IOT_Dev_Brd-v2.0.PrjPcb
Design Files/Industrial IOT development board-v2.0/Power-Relay-Sheet.SchDoc
Design Files/Industrial IOT development board-v2.0/Power-Sheet.SchDoc
Design Files/Industrial IOT development board-v2.0/RS485-Sheet.SchDoc
Design Files/Industrial IOT development board-v2.0/Terminal-Sheet.SchDoc
