eSpark-Backup/alexy-ouden-industrial-iot-board/(commit log)

2025-02-11 #1 Updated Schematic design (in progress)
    [Connector_Sheet.SchDoc, Controller_Sheet.SchDoc, Industrial_IOT_Dev_Brd.PrjPcb, Power_Sheet.SchDoc]
2025-02-13 #1 In Progress.
    [Battery-Charging-Sheet.SchDoc, Connector_Sheet.SchDoc, Controller-Sheet.SchDoc, Controller_Sheet.SchDoc, Industrial_IOT_Dev_Brd.PrjPcb, Power-Relay-Sheet.SchDoc, Power-Sheet.SchDoc, Power_Relay_Sheet.SchDoc]
2025-02-13 #1 Digital In sheet done
    [Controller-Sheet.SchDoc, Digital-Input-Sheet.SchDoc, Industrial_IOT_Dev_Brd.PrjPcb, Power-Sheet.SchDoc, Terminal-Sheet.SchDoc]
2025-02-14 #1 Analog input sheet added. I2C expansion header remaining
    [Analog-Input-Sheet.SchDoc, Controller-Sheet.SchDoc, Digital-Input-Sheet.SchDoc, Power-Sheet.SchDoc, Terminal-Sheet.SchDoc]
2025-02-14 #1 Individual LED on relays added. PDF updated.
    [Analog-Input-Sheet.SchDoc, Battery-Charging-Sheet.SchDoc, Controller-Sheet.SchDoc, Digital-Input-Sheet.SchDoc, Industrial_IOT_Dev_Brd.PrjPcb, PCB1.PcbDoc, Power-Relay-Sheet.SchDoc, Power-Sheet.SchDoc]
2025-02-17 #1 Dip switch part updated with its 3D body
    [Controller-Sheet.SchDoc, Industrial_IOT_Dev_Brd.PrjPcb]
2025-02-18 Add: version numbering to files
    [Analog-Input-Sheet.SchDoc, Battery-Charging-Sheet.SchDoc, Controller-Sheet.SchDoc, Digital-Input-Sheet.SchDoc, Industrial_IOT_Dev_Brd-v1.0.PrjPcb, Power-Relay-Sheet.SchDoc, Power-Sheet.SchDoc, Terminal-Sheet.SchDoc]
2025-02-26 #1 Complete
    [Analog-Input-Sheet.SchDoc, Battery-Charging-Sheet.SchDoc, Controller-Sheet.SchDoc, Digital-Input-Sheet.SchDoc, Ethernet-PoE-Sheet.SchDoc, Industrial_IOT_Dev_Brd-v1.0.PrjPcb, Power-Relay-Sheet.SchDoc, Power-Sheet.SchDoc]
2025-02-26 #1 Minor updates. Designators updated
    [Analog-Input-Sheet.SchDoc, Battery-Charging-Sheet.SchDoc, Controller-Sheet.SchDoc, Digital-Input-Sheet.SchDoc, Ethernet-PoE-Sheet.SchDoc, Power-Relay-Sheet.SchDoc, Power-Sheet.SchDoc, RS485-Sheet.SchDoc]
2025-02-26 #1 3D model updates. PDF generated
    [Controller-Sheet.SchDoc, Ethernet-PoE-Sheet.SchDoc, Industrial_IOT_Dev_Brd-v1.0.PrjPcb, Power-Sheet.SchDoc, RS485-Sheet.SchDoc, Terminal-Sheet.SchDoc]
2025-02-26 #1 Expansion header changed. PDF updated.
    [Controller-Sheet.SchDoc, Ethernet-PoE-Sheet.SchDoc]
2025-02-27 #1 Power slide switch updated. PDF updated.
    [Power-Sheet.SchDoc]
2025-02-27 #1 Switch connection change. PDF updated
    [Power-Sheet.SchDoc]
2025-02-28 #1 Part number updated. Same functionality updated part number. PDF updated.
    [Power-Sheet.SchDoc]
2025-02-28 #1 Inductor missing net added. PDF updated
    [Battery-Charging-Sheet.SchDoc, Power-Sheet.SchDoc]
2025-02-28 #2 in Progress
    [Industrial_IOT_Dev_Brd-v1.0.PcbDoc, Industrial_IOT_Dev_Brd-v1.0.PrjPcb]
2025-03-03 #1 Capacitor added. W5500 resistor sip connections adjusted according to PCB easiness. PDF updated
    [Ethernet-PoE-Sheet.SchDoc, Power-Sheet.SchDoc]
2025-03-03 #2 Placement Completed
    [Industrial_IOT_Dev_Brd-v1.0.PcbDoc]
2025-03-03 #3 Client BOM added.
    [Client-BOM-v1.0.xlsx]
2025-03-04 #2 Routing In Progress
    [Industrial_IOT_Dev_Brd-v1.0.PcbDoc]
2025-03-04 #3 Peripheral added.
    [Client-BOM-v1.0.xlsx, JLCPCB-BOM-v1.0.xlsx]
2025-03-04 #3 Poe Injector added in BOM.
    [Client-BOM-v1.0.xlsx]
2025-03-04 #1 Few parts replaced to avoid global sourcing... Few remaining.
    [Controller-Sheet.SchDoc, Power-Sheet.SchDoc, RS485-Sheet.SchDoc, Terminal-Sheet.SchDoc]
2025-03-04 #1 All changes for JLC parts changes complete. PDF updated
    [Industrial_IOT_Dev_Brd-v1.0.PrjPcb, Power-Sheet.SchDoc, RS485-Sheet.SchDoc]
2025-03-05 #2 PCB components changes imported...
    [Industrial_IOT_Dev_Brd-v1.0.PcbDoc, Industrial_IOT_Dev_Brd-v1.0.PrjPcb]
2025-03-05 #3 Client and JLCPCB BOM Updated.
    [Client-BOM-v1.0.xlsx, Industrial_IOT_Dev_Brd-v1.0.xlsx, JLCPCB-BOM-v1.0.xlsx]
2025-03-06 #2 PCB Design Completed and Deliverables Generated
    [Industrial_IOT_Dev_Brd-v1.0.GBL, Industrial_IOT_Dev_Brd-v1.0.GBO, Industrial_IOT_Dev_Brd-v1.0.GBP, Industrial_IOT_Dev_Brd-v1.0.GBS, Industrial_IOT_Dev_Brd-v1.0.GKO, Industrial_IOT_Dev_Brd-v1.0.GTL, Industrial_IOT_Dev_Brd-v1.0.GTO, Industrial_IOT_Dev_Brd-v1.0.GTP]
2025-03-06 #2 Centroid file modified
    [Centroid.csv]
2025-03-06 #2 Deliverables Updated
    [Industrial_IOT_Dev_Brd-v1.0.GBL, Industrial_IOT_Dev_Brd-v1.0.GBO, Industrial_IOT_Dev_Brd-v1.0.GBP, Industrial_IOT_Dev_Brd-v1.0.GBS, Industrial_IOT_Dev_Brd-v1.0.GKO, Industrial_IOT_Dev_Brd-v1.0.GTL, Industrial_IOT_Dev_Brd-v1.0.GTO, Industrial_IOT_Dev_Brd-v1.0.GTP]
2025-03-13 #5 Version number update
    [Analog-Input-Sheet.SchDoc, Battery-Charging-Sheet.SchDoc, Centroid.csv, Controller-Sheet.SchDoc, Digital-Input-Sheet.SchDoc, Ethernet-PoE-Sheet.SchDoc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]
2025-03-13 #5 Schematic Changes complete. PDF generated
    [Analog-Input-Sheet.SchDoc, Battery-Charging-Sheet.SchDoc, Centroid.csv, Controller-Sheet.SchDoc, Digital-Input-Sheet.SchDoc, Ethernet-PoE-Sheet.SchDoc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]
2025-03-13 #5 In Progress
    [Industrial_IOT_Dev_Brd-v2.0.PcbDoc, Industrial_IOT_Dev_Brd-v2.0.PrjPcb]
2025-03-14 #6 Routing in Progress
    [Industrial_IOT_Dev_Brd-v2.0.PcbDoc, Industrial_IOT_Dev_Brd-v2.0.PrjPcb, Power-Sheet.SchDoc]
2025-03-15 #6 Completed and Deliverables Generated
    [Centroid File.csv, Industrial_IOT_Dev_Brd-v2.0..DWG, Industrial_IOT_Dev_Brd-v2.0.DXF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]
2025-03-16 #6 Client and JLC BOM's added.
    [Industrial_IOT_Dev_Brd-v2.0.xlsx, JLCPCB-BOM-v2.0.xlsx]
2025-05-02 Add: client LED test code
2025-05-02 Fix: Configurations for led fixed.
    [led_strip_encoder.c]
2025-05-06 Fix: Timing fix as per client need.
    [led_strip_encoder.c]
